anhquan-dao/Power-Meter/reports/cover_page.tex

%!TeX root = power_rail
\documentclass[main.tex]{subfiles}

\begin{document}
    \begin{figure}[!h]
        \hspace{-2.0cm}
        \begin{subfigure}{0.5\textwidth}
         
        \end{subfigure}
        \hspace{6.0cm}
        \begin{subfigure}{0.5\textwidth}
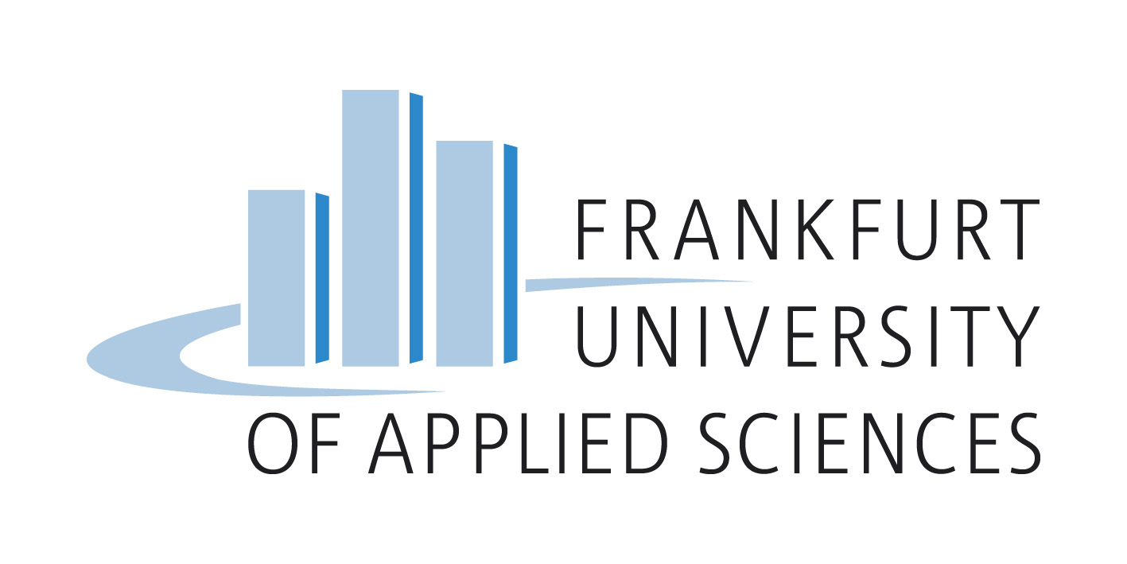
[picture p1: reports/media/FRA-UAS_Logo_rgb.jpg]
        
        \end{subfigure}
    \end{figure}

    \vspace{5mm}
    \center
    \textbf{Vietnamese-German University}
    \center
    \textbf{Department of Electrical Engineering \& Information Technology}
    \vspace{3mm}
    \center
    \textbf{Frankfurt University of Applied Science}
    \center
    \textbf{Faculty 2: Computer Science and Engineering}

    \vspace{2cm}
    \center
    \hspace{-1cm}
    {\Large\textbf{Design and Build a Power Meter with Protection and Visualization}} 
    \hspace{1cm}
    \center
    By
    \center
    {\large\textbf{DAO NGUYEN ANH QUAN}} 
    \center
    \textbf{Matriculation Number: 1318490}
    \center  
    \vspace{5mm}
    {\large\textbf{Supervisor : Dr. THAI TRUYEN DAI CHAN}} 
    \center
    {\large\textbf{Second Supervisor : MSc. NGUYEN VO THAT THUYET}} 

    \vspace{2cm}
    \centerline{Submitted in partial fulfillment of the requirements}
    \centerline{for the degree of Bachelor Engineering in the study program}
    \centerline{Electrical Engineering \& Information Technology,}
    \centerline{Vietnamese-German University.}
    \centerline{Binh Duong, July 2023.}

    \pagebreak
    \section*{\centering{Disclaimer}}
    \justify
    I declare that this report is my analysis of various papers, except the references. All theories, formulas, and models, are researched and collected under the supervisor of MSc. Nguyen Vo That Thuyet, Dr. Thai Truyen Dai Chan.
    \justify
    \hspace{10cm}Dao Nguyen Anh Quan

    \pagebreak
    \section*{\centering{Acknowledgement}}
    \justify
    I would like to extend my most sincere thanks to MSc. Nguyen Vo That Thuyet, Dr. Thai Truyen Dai Chan for his supervision. As well as my peers and my family that has given me advice and support during all this time.

    \pagebreak
    \section*{\centering{Abstract}}
    \justify
    Power monitor is critical in every field of electronics and electrical. Devices used outside their voltage, current and power rating will likely be damaged beyond repair. Thus, in this thesis, the design and construction of an intermediate device between a power supply and a load which provides overvoltage, overcurrent, over-power protection with configurable threshold is discussed. An application is also built to use alongside such device to visualize the opearting voltage and current traces of the load, and to actively disconnect the load.

\end{document}
