anhquan-dao/Power-Meter/reports/MOSFET_selection.tex

%!TeX root = MOSFET_selection
\documentclass[main.tex]{subfiles}

\begin{document}
    \section{MOSFET selection}
    \justify
    In this section, the criteria of selecting a suitable MOSFET are discussed.
    \begin{enumerate}
        \item \nameref{sec:switch_type}.
        \item \nameref{sec:on_resistance}.
        \item \nameref{sec:gate_charge}.
        \item \nameref{sec:soa}.
        \item \nameref{sec:irf4905}.
    \end{enumerate}

    \pagebreak
    \subsection{MOSFET switching principle} \label{sec:switch_type}

    \justify
    The N-channel and P-channel MOSFET have different turn-on conditions:
    \begin{itemize}
        \item For the N-channel MOSFET to be  "switched on" (in triode or saturation region), $V_{gs} > V_{th}$ with Gate-Source threshold voltage $V_{th} > 0$. To achieve this, a simple circuit such as in Figure \ref{fig:simple_nmos_switch} can be used. This configuration is called \textbf{Low-side Switch} where  the switch (MOSFET) is connected to the negative terminal of the supply voltage.
        \item For the P-channel MOSFET, the turn-on condition is $V_{gs} < V_{th}$ with $V_{th} < 0$ which leads to the simple circuit shown in Figure \ref{fig:simple_pmos_switch}. This configuration is called \textbf{High-side Switch} where the switch is connected to the positive terminal of the supply voltage.
    \end{itemize}

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

    \pagebreak
    \subsection{On resistance $R_{ds}$} \label{sec:on_resistance}
    N-channel MOSFET exhibits lower $R_{ds}$ than that of P-channel MOSFET due to packing density. It is possible to parallel two or more P-channel MOSFETs to reduce the total on resistance $R_{\sum ds}$. However, the designer has to take into account devices' parameters mismatch. An application note from Infineon and Texas Instruments \cite{InfineonParallelMOS} details the effects and solutions of each mismatches, suitable for paralleling up to 4 MOSFETs. However, \cite{MOSFET_parallel_low_power} shows that for low power application, the parameter mismatches is not as detrimental as for high power application.
    
    \pagebreak
    \subsection{Gate Charge} \label{sec:gate_charge}

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

    \pagebreak
    \subsection{Safe Operating Area (SOA)} \label{sec:soa}
    In a MOSFET's datasheet, the SOA of the device shows the limitation of the device's opreating range. As long as the desired application is well within the SOA, the device will, in all likelihood, not risk running into problems such as thermal runaway, material degradation, etc. A typical SOA plot of a P-channel MOSFET is shown in figure \ref{fig:typical_SOA_plot}. The SOA lies below the dashed boundary.

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

    \pagebreak
    \subsection{IRF4905S} \label{sec:irf4905}

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

    \end{table}    

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

    \begin{figure}[!h]
        \centerline{}
        \caption{IRF4905 P-channel MOSFET key parameter \cite{IRF4905S}.}
        \label{fig:IRF4905S_param}
    \end{figure}    
    
\end{document}
