anhquan-dao/Power-Meter/reports/application/application.tex

%!TeX root = application
\documentclass[../main.tex]{subfiles}

\begin{document}
    \section{Flask}    \label{sec:flask}
    Flask is a web application framework written in Python. To be more precise, Flask is a microframework which means it is extensible and is not dependent on third-party library, or, in other word, plug and play. The 

    \pagebreak
    \section{Controller's flowchart} \label{sec:application_flowchart}
    The following diagram is the application's flowchart.
    \begin{figure}[!h]
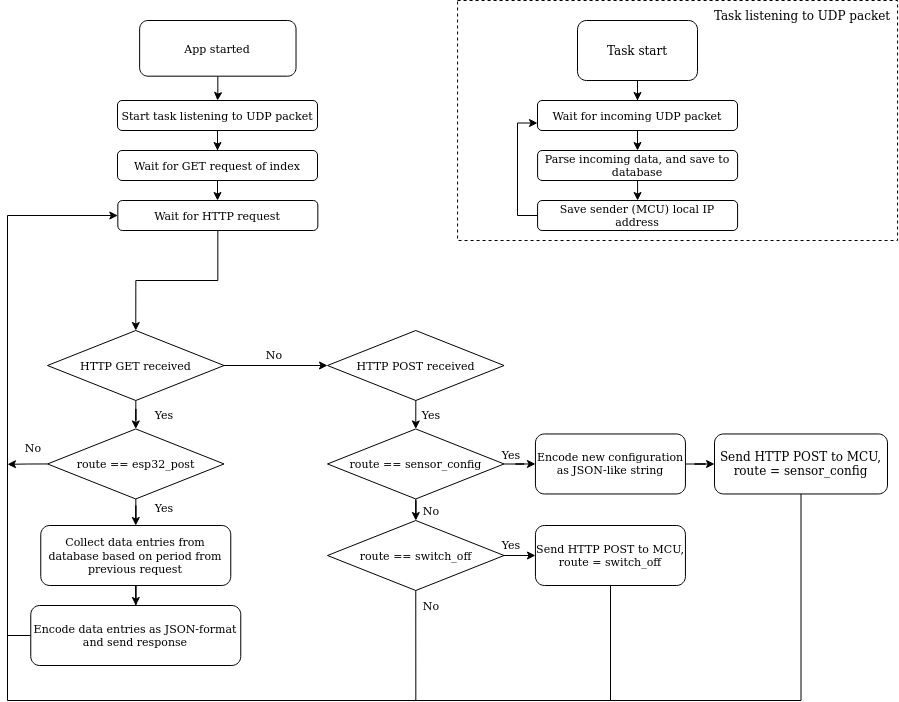
[picture p72: reports/media/appliation_flowchart.drawio.png]
        \centerline{}
        \caption{Application's flowchart.}
        \label{fig:application_flowchart}
    \end{figure}

    \justify
    \begin{itemize} 
        \item An asynchronous task reading incoming UDP packets is started with the application. The asynchronous task parses and saves the incoming data to the database. The sender (MCU)'s local IP address is also stored for other operation.
        \item The web application can then be accessed in the preferred browser with the host PC/laptop's local IP adress at port 8090.
        \item The first GET request is for acquiring the html of the main page.
        \item A GET request with requested resource "esp\_post" is sent every 1000ms from client to the host. The response includes all the data entries from the previous request time up until now. Thus, no data entries sent by the MCU will not be missed.
        \item Other POST requests are "redirected" to the MCU with similar route discussed in previous section.
    \end{itemize}

    \pagebreak
    \section{View's design} \label{sec:application_flowchart}
    \subsection{Embedded JavaScript functions}
    \justify
    The frontend is built using Bootstrap v5.0 framework, Plotly graphing library, and Asynchronous JavaScript and XML (AJAX). The following code snippet shows the JaveScript functions embedded in the .html file.

    \lstinputlisting[language=JavaScript]{code/app/index.js}

    \justify
    \begin{itemize}
        \item The function \lstinline[language=JavaScript]{updateGraph} extends the traces with the values acquired from the server.
        \item The function \lstinline[language=JavaScript]{requestData} is called periodically using \lstinline[language=JavaScript]{setInterval}. After a response is received, the graph is updated with function \lstinline[language=JavaScript]{updateGraph}.
        \item The function \lstinline[language=JavaScript]{submitForm} can be used in \lstinline[language=HTML]{onSubmit} tag of a form element to prevent the page from reloading, and update elements in the background (asynchronously).
    \end{itemize}
    
    \pagebreak
    \subsection{Webpage}
    \justify
    The following figures are the visual design of the webpage of the index.html and config.html respectively. The form in the configuration page uses function \lstinline[language=JavaScript]{submitForm} for its \lstinline[language=HTML]{onSubmit} tag.
    \begin{figure}[!h]
        \centerline{}
        \caption{Index page design}
        \label{fig:index_html}
    \end{figure}
    \begin{figure}[!h]
        \centerline{}
        \caption{Configuration page design}
        \label{fig:config_html}
    \end{figure}

\end{document}
