anhquan-dao/Power-Meter/presentation/media/flask_celery.png

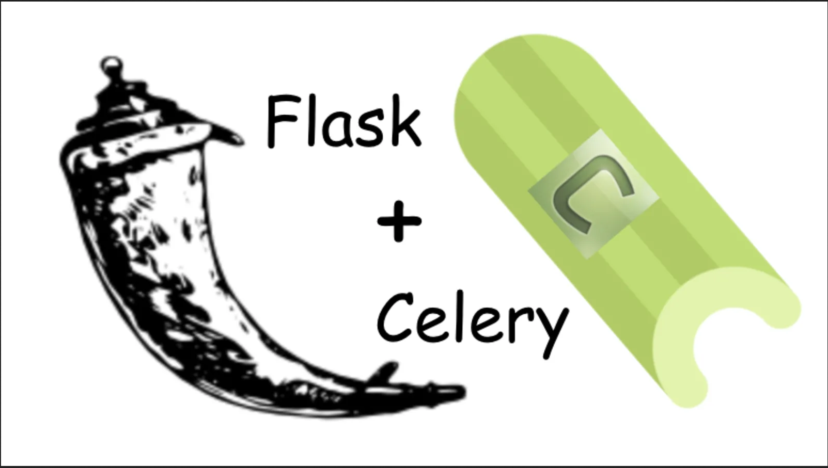
presentation/media/flask_celery.png
