anhquan-dao/Power-Meter/presentation/media/latch_circuit_OFF.png

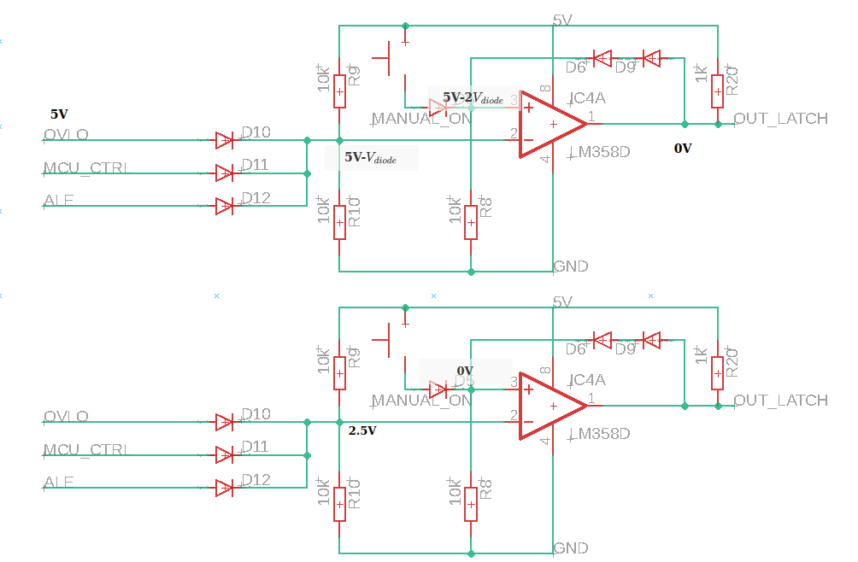
presentation/media/latch_circuit_OFF.png
