anhquan-dao/Power-Meter/reports/media/2.bmp

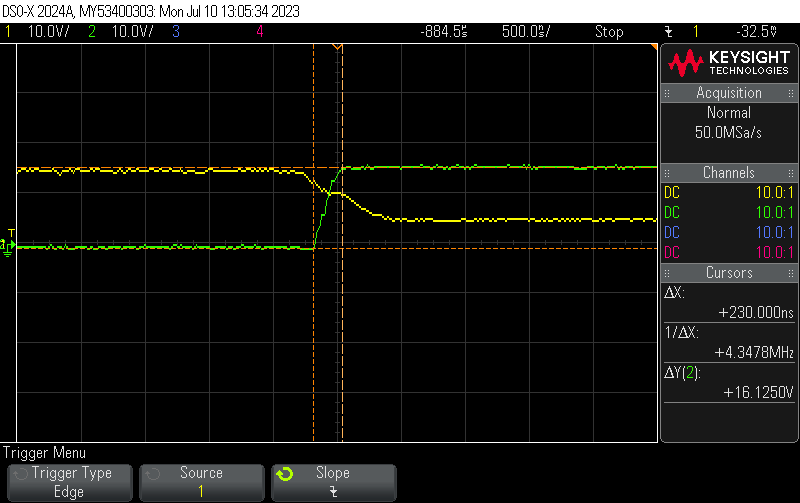
reports/media/2.bmp
