anhquan-dao/Power-Meter/reports/media/example_NMOS_low_switch.png

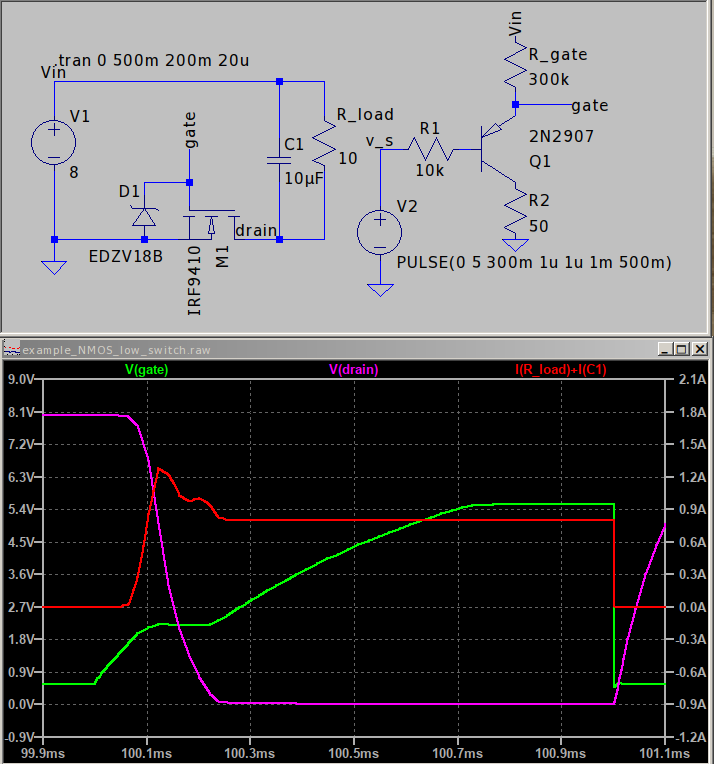
reports/media/example_NMOS_low_switch.png
