anhquan-dao/Power-Meter/reports/media/gate_charge_curve.png

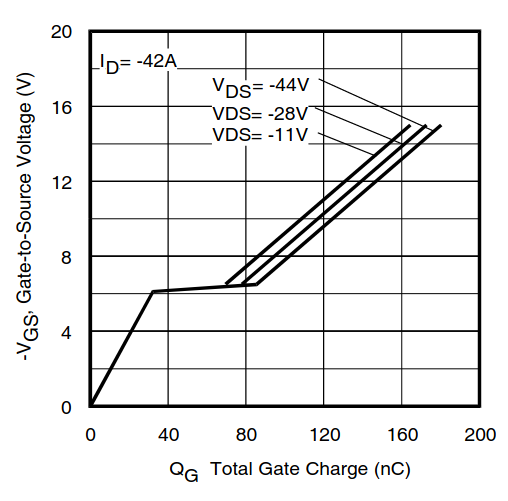
reports/media/gate_charge_curve.png
