anhquan-dao/Power-Meter/reports/media/gate_charge_curve_2.png

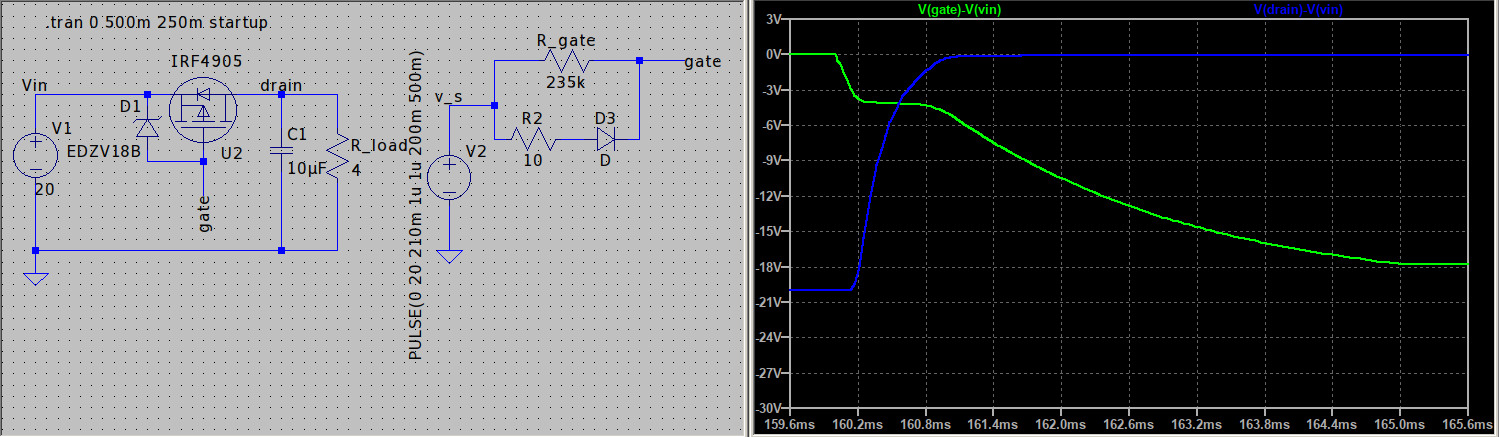
reports/media/gate_charge_curve_2.png
