anhquan-dao/Power-Meter/reports/media/gate_charge_curve_3.png

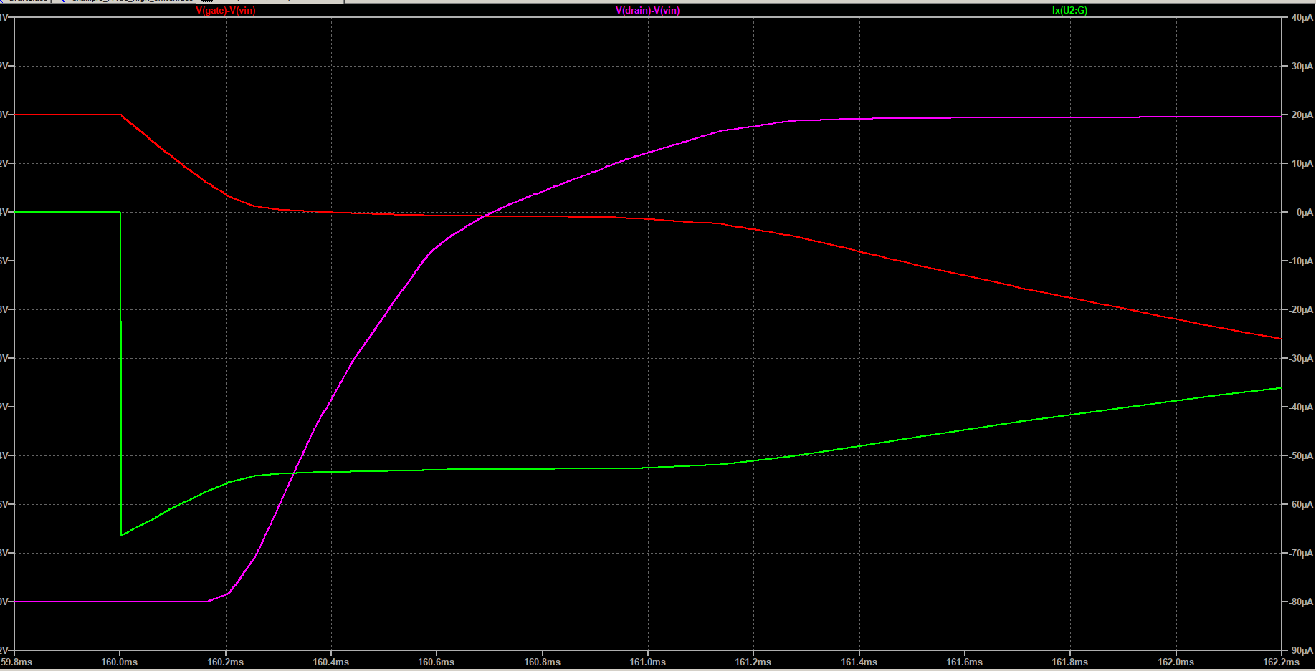
reports/media/gate_charge_curve_3.png
