anhquan-dao/Power-Meter/reports/media/ina226_board.jpeg

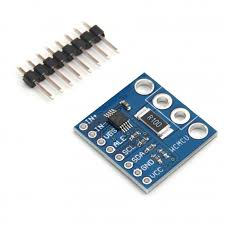
reports/media/ina226_board.jpeg
