anhquan-dao/Power-Meter/reports/media/MC3x063A_inverting_regulator.png

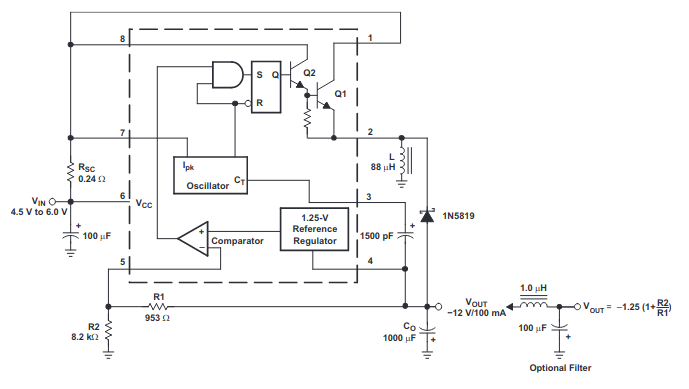
reports/media/MC3x063A_inverting_regulator.png
