anhquan-dao/Power-Meter/reports/media/power-power75.gif

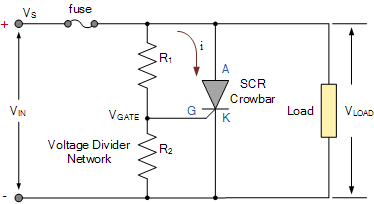
reports/media/power-power75.gif
