anhquan-dao/Power-Meter/reports/media/power_meter_pcb_v2_2_bottom.png

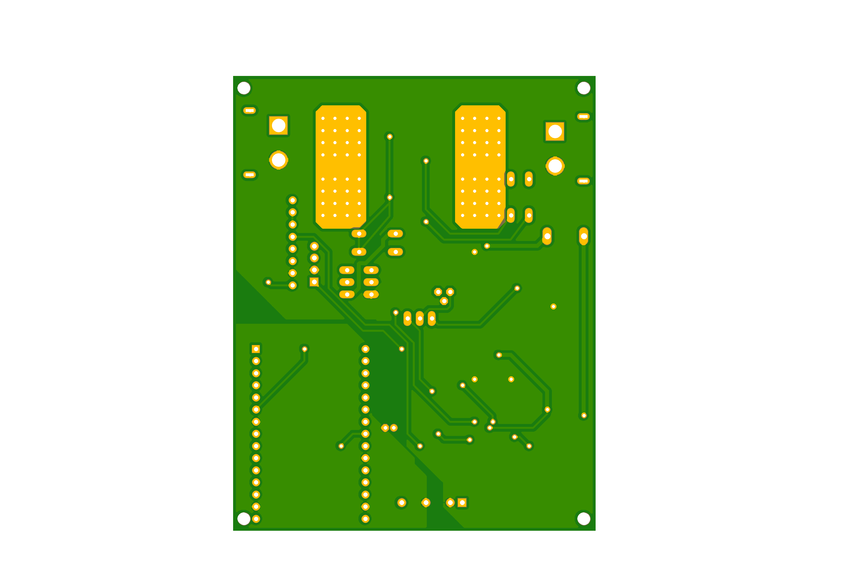
reports/media/power_meter_pcb_v2_2_bottom.png
