anhquan-dao/Power-Meter/reports/media/SOA_circuit.png

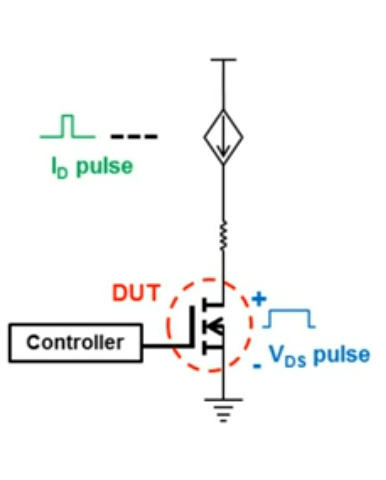
reports/media/SOA_circuit.png
