anhquan-dao/Power-Meter/presentation/build/main.pdf

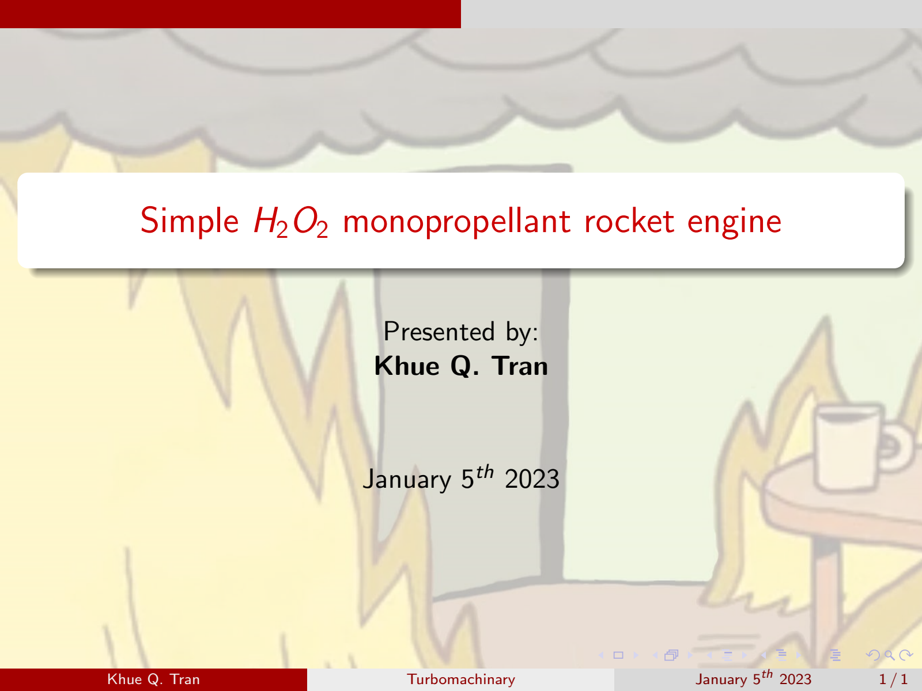
[picture p85: page 1]

## Simple H2O2 monopropellant rocket engine

Presented by:
Khue Q. Tran

January 5th 2023

Khue Q. Tran | Turbomachinary | January 5th 2023 | 1 / 1

Table of conents

Khue Q. Tran | Turbomachinary | January 5th 2023 | 2 / 1

Introduction Safety

## Safety

A rocket engine is always dangerous due to the release of gas and energy! For this rocket engine design, the propellant is high concentration of hydrogen peroxide (H2O2).

At low concentration, H2O2 is safe and used widely for household applications. However, at high concentrations, H2O2 is dangerous due to its oxidizing properties that could lead to skin burn in contact. H2O2 is not stable, may decompose into oxygen and water, and release a lot of energy. This decomposition happens rapidly and lead to damages
H2O2 is not compatible with commons materials: brass (usually used for pneumatics equipments), buna rubber (usually in O-rings/sealing), oil-based grease. The construction materials should be stainless steel or aluminum, Teflon-based O-rings/sealing and grease.
Khue Q. Tran | Turbomachinary | January 5th 2023 | 3 / 1

Introduction System requirements

## Mission type

The concept mission is a small lander: Thrust adequate for the lander: 250N

Required burn time: 40s
Ease to ignite and shut down
Low cost and ease to manufacture


Figure: Masten Xombie test vehicle

Khue Q. Tran | Turbomachinary | January 5th 2023 | 4 / 1

Rocket engine principle de Laval nozzle

## de Laval nozzle


At the convergence section, the flow is ”choked” to sonic flow. Theoretically, any further reduction in cross-section does not increase the flow velocity. Theoretically, the ratio between divergence section inlet and the throat is about 1.5. At the divergence section, the flow is accelerated to supersonic flow. The divergence section expansion ratio depends on the ratio between inlet and ambient pressure. In case of vacuum, the limit factor of
expansion ratio is surface tension
and condensation of the fluid.
Khue Q. Tran | Turbomachinary | January 5th 2023 | 5 / 1

Rocket engine principle de Laval nozzle
The values usually use to parameterize the nozzle’s geometry Throat diameter: from characteristics thrust CF Divergence section
Exit diameter: from expansion ratio At/Ae
Divergence half angle α, usually 15◦

Convergence section
Combustion chamber length: based on combustion, O/F mixing... Combustion chamber diameter: from conctraction ratio Convergence half angle θ, usually in the range of 20◦

to 45◦

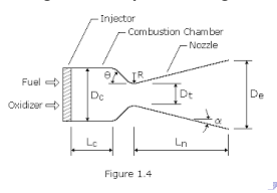
[picture p86: figure]

Khue Q. Tran | Turbomachinary | January 5th 2023 | 6 / 1

Rocket engine principle de Laval nozzle

## Design parameter for a de Laval nozzle

Throat size → Depends on mass flow
rate through the nozzle
Throat expansion ratio, which affects divergence section length is Aexit/Ainlet → Depends on pressure ratio between combustion chamber and ambient, and combustion enthalpy
Convergence and divergence half angles are calculated from real fluid’s surface tension, boundary layer, Raynold number → For an ideal nozzle without any loss, the nozzle could be an orifice. In practice, these angles are usually in a
consistent range

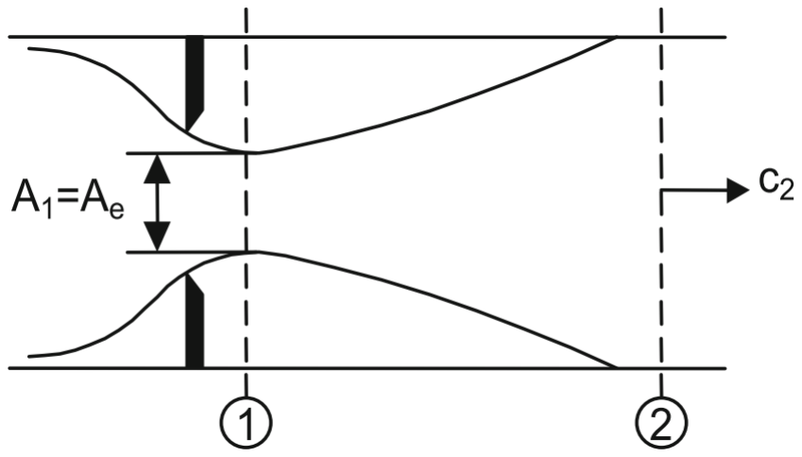
[picture p87: figure]

Khue Q. Tran | Turbomachinary | January 5th 2023 | 7 / 1

## Design parameter for a de Laval nozzle

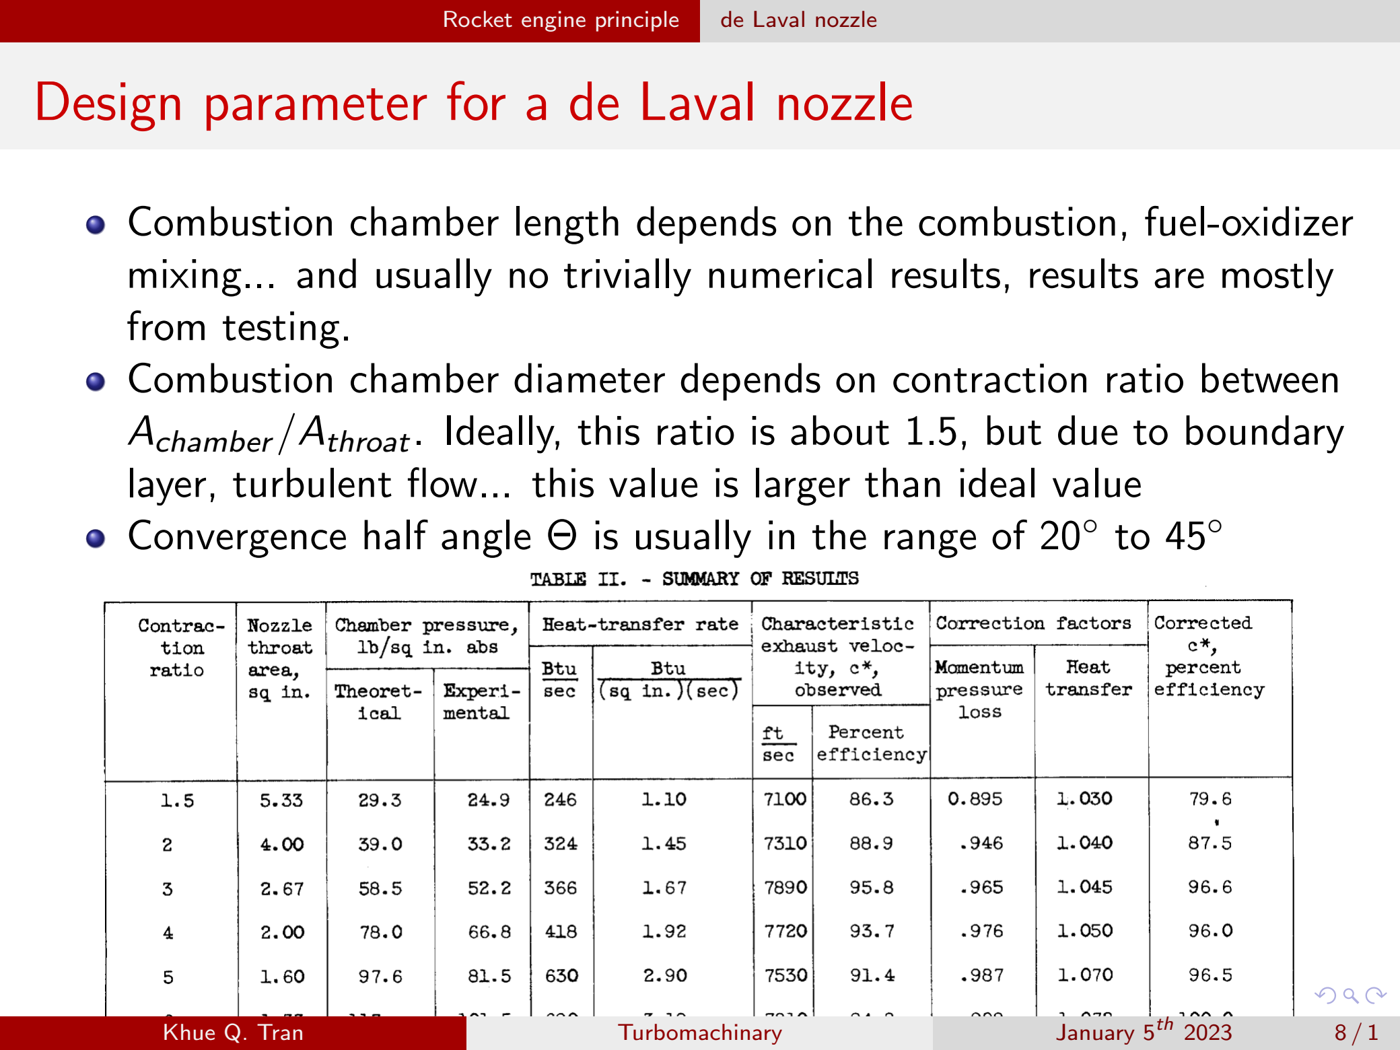
[picture p88: page 8]

Rocket engine principle de Laval nozzle

Combustion chamber length depends on the combustion, fuel-oxidizer mixing... and usually no trivially numerical results, results are mostly from testing.
Combustion chamber diameter depends on contraction ratio between Achamber /Athroat. Ideally, this ratio is about 1.5, but due to boundary layer, turbulent flow... this value is larger than ideal value Convergence half angle Θ is usually in the range of 20◦

to 45◦

Khue Q. Tran | Turbomachinary | January 5th 2023 | 8 / 1

Rocket engine principle Pressure-fed cycle

## Pressure-fed cycle

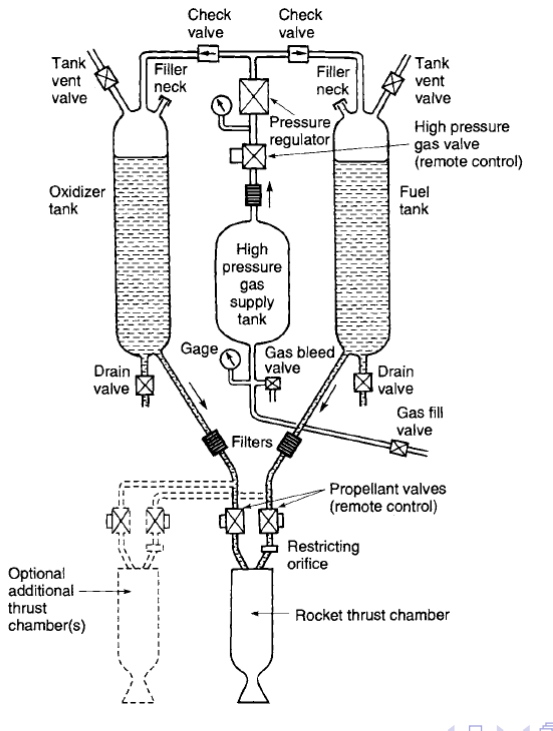
[picture p89: figure]

Khue Q. Tran | Turbomachinary | January 5th 2023 | 9 / 1

Rocket engine principle Hydrogen peroxide

## Why Hydrogen peroxide?

Hydrogen peroxide is a liquid at room temperature and pressure → Could be easily stored and require no thermal insulation

Could decompose and release energy without the presence of other fuels
→ Does not require complex system compared with bipropellant

The decomposition is autogenous with catalyst
→ Ease to ignite and restart
Safe (with low concentration)
→ In case of malfunction, hydrogen peroxide could be easily neutralized by diluting with water
Khue Q. Tran | Turbomachinary | January 5th 2023 | 10 / 1

Rocket engine principle Hydrogen peroxide

## Hydrogen peroxide decomposition

The decomposition of H2O2

2H2O2 → 2H2O + O2

generates ∆H = –2884.5kJ/kg at standard condition T = 25◦C, 1 atm This decomposition usually requires a catalyst. Usually, the catalyst used is silver (both in pure form or silver coated)


Figure: Silver mesh catalyst bed

Khue Q. Tran | Turbomachinary | January 5th 2023 | 11 / 1

Development Engineering consideration

## Engineering consideration

The engine runs on a pressure-fed cycle
High-pressure gas supply tank is limited to 300 bar (30MPa) The engine runs by H2O2 monopropellant (the energy is from the decomposition of H2O2 only)
The concentration of H2O2 is 80%
Khue Q. Tran | Turbomachinary | January 5th 2023 | 12 / 1

Development Sample chamber-nozzle geometry calculation

## First law of thermodynamics

Rocket engine is the heat engine, which must satisfy the first law of Thermodynamics for flow in an adiabatic nozzle

h2 − h1 = −

1
2 × (c

2
2 − c
2/1)

For non-ideal gas, the enthalpy is the function of
H(pressure,Temperature). There are no such models universally, to determine these enthalpy values
→ The enthalpy values usually come from real measurement, and complex state equations, for each kind of substance! Usually, we use numerical software to calculate the thermodynamic properties of the rocket engine.
Khue Q. Tran | Turbomachinary | January 5th 2023 | 13 / 1

Development Sample chamber-nozzle geometry calculation

## NASA CEA demo for thermodynamics calculation

Initial conditions
H2O2 80% monopropellant (20% left is water)

Combustion chamber pressure is 30 bar, ambient pressure is 1 bar, ratio=30
Initial H2O2 temperature: 293.15K

https://cearun.grc.nasa.gov/

Khue Q. Tran | Turbomachinary | January 5th 2023 | 14 / 1

Development Sample chamber-nozzle geometry calculation

## Sample NASA CEA result

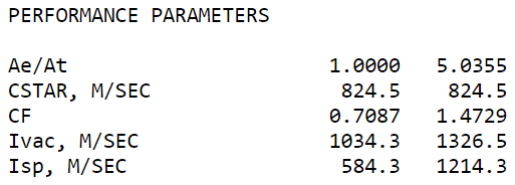
[picture p90: figure]

Khue Q. Tran | Turbomachinary | January 5th 2023 | 15 / 1

Development Sample chamber-nozzle geometry calculation

## Sample chamber-nozzle geometry calculation

The combustion temperature is 782.05K (508.9

◦C. It is a relatively
low value for metal materials. Hence, it does not require to cool down the engine, and no need to calculate heat transfer

For the required thrust of 250N, the required mass flow rate is

m˙ [kg] = Fthrust[N]
Isp[m/s] =

250N
1214.3m/s = 0.206kg/s

Throat area
At

[in²

] = Fthrust[lbf ] Cf ×pchamber [psi] =
56.2lbf
1.4729×435.1psi = 0.0877in² = 56.59mm²

→ The throat diameter Dthroat = 8.5mm

Nozzle exit diameter

Dexit = Dthroat ×

q Aexit

Athroat

= 8.5mm ×

√
5.0355 = 19.1mm
Khue Q. Tran | Turbomachinary | January 5th 2023 | 16 / 1

Development Sample chamber-nozzle geometry calculation

## Sample chamber-nozzle geometry calculation

For this simple engine, some characteristics properties are Geometry is linear (which is about 93% efficiency)

Combustion chamber-throat concentration: 2.5

dchamber = dthroat ×

√
contraction ratio = 8.5mm ×

√
2.5 = 13.44mm
Combustion chamber length/diameter ratio: 4

Lchamber = dchamber ×

L
D = 13.44mm × 4 = 53.76mm
Converging half angle: Θ = 30◦ Diverging half angle: α = 15◦
Khue Q. Tran | Turbomachinary | January 5th 2023 | 17 / 1

Development Sample chamber-nozzle geometry calculation

## Sample chamber-nozzle geometry calculation

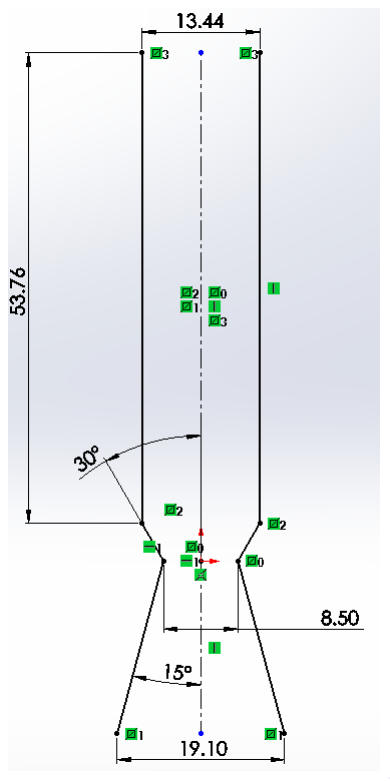
[picture p91: figure]

Khue Q. Tran | Turbomachinary | January 5th 2023 | 18 / 1

Development Sample chamber-nozzle thickness calculation

## Sample chamber-nozzle thickness calculation

Due to manufacturing constraints, the nozzle assembly is 3D-printed, AlSi10Mg alloy. This material has tensile strength of 210MPa. Safety factor for this engine is at least SF = 2 . There are 3 consumptions The material loss 30% percent of its strength at 782.05K

The thickness is the same for the whole assembly. The 3D-printed part strength is homogeneous in all directions
The stress is highest at combustion chamber
Hoop (Circumferential) Stress for thin-walled vessel

σh × SF =

pd
2t
Longitudinal (Axial) Stress for thin-walled vessel

σl × SF =

pd
4t
⇒ t = 2.5mm with SF = 2.3
Khue Q. Tran | Turbomachinary | January 5th 2023 | 19 / 1

Development | Sample chamber-nozzle thickness calculation

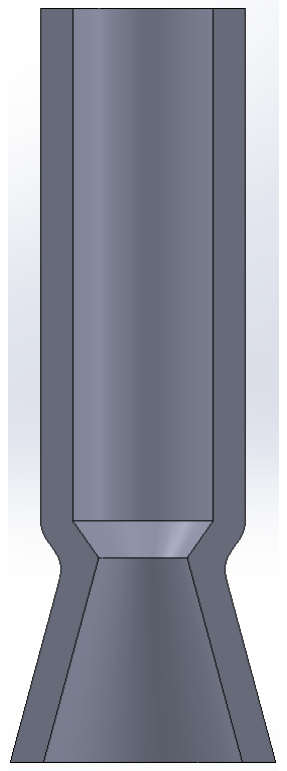
[picture p92: figure]

Khue Q. Tran | Turbomachinary | January 5th 2023 | 20 / 1

Development Simple injector

## Simple injector

A rocket engine injectors has two main contributions
Mix the fuel and oxidizer
Act as a flow-restricting orifice to prevent the combustion gas to blow-back into feed line. This is different from normal injector that used in internal-combustion engine as rocket engine is a continuously flow engine

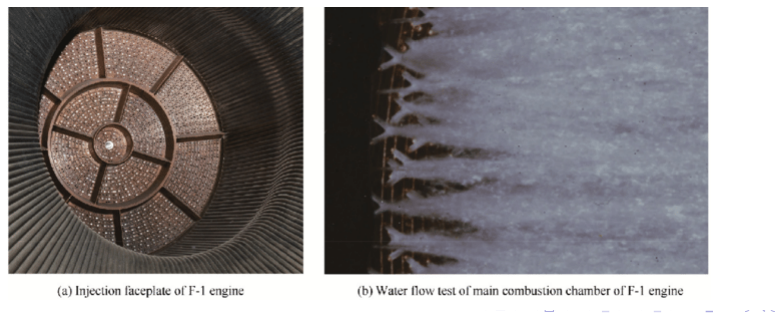
[picture p93: figure]

Khue Q. Tran | Turbomachinary | January 5th 2023 | 21 / 1

Development Simple injector

For our simple H2O2 engine, there is no mixing as our engine is monopropellant.
→ The nozzle could be a simple spray nozzle.

For combustion stability, the pressure drop through the injector is 15% to 20%
→ For combustion pressure of 30 bar, the pressure drop is 6 bar. Also, as the mass flow rate is ˙m = 0.206kg/s and ρH2O2 = 1.4kg/l, the volumetric flow rate is V˙ = 0.2884l/s = 4.57gpm (gallon per minute)

From volumetric flow rate and pressure drop,
we could find the spray nozzle orifice diameter (ISO 5167 standard for spray nozzle). An online tool: http://www.pressure-drop.com/Online-Calculator/index.html (http://www.pressure-drop.com/Online-Calculator/index.html)

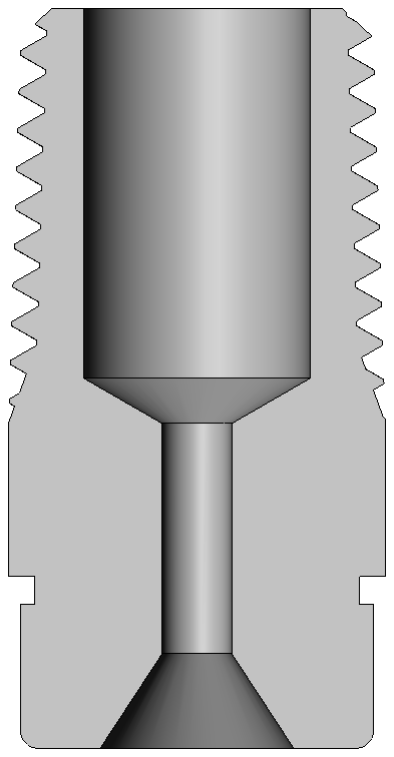
[picture p94: figure]

Khue Q. Tran | Turbomachinary | January 5th 2023 | 22 / 1

Development Simple injector

## McMaster-Carr nozzle

Instead of calculating, the flowrate and pressure drop could be supplied by the spray nozzle manufacture. In this case, we chose Mcmaster-Carr 32885K571 spray nozzle (https://www.mcmaster.com/32885K571/)

This spray nozzle is stainless steel
This spray nozzle is 120◦
, full-cone type

Flow rate at 100psi pressure drop is 4.6gpm

Khue Q. Tran | Turbomachinary | January 5th 2023 | 23 / 1

Design result

## Overall CAD file

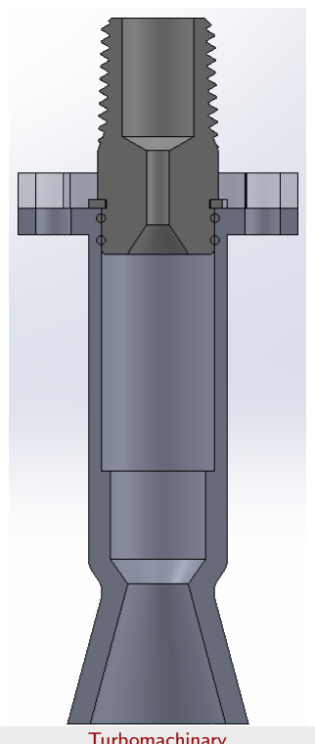
[picture p95: figure]

Khue Q. Tran | Turbomachinary | January 5th 2023 | 24 / 1

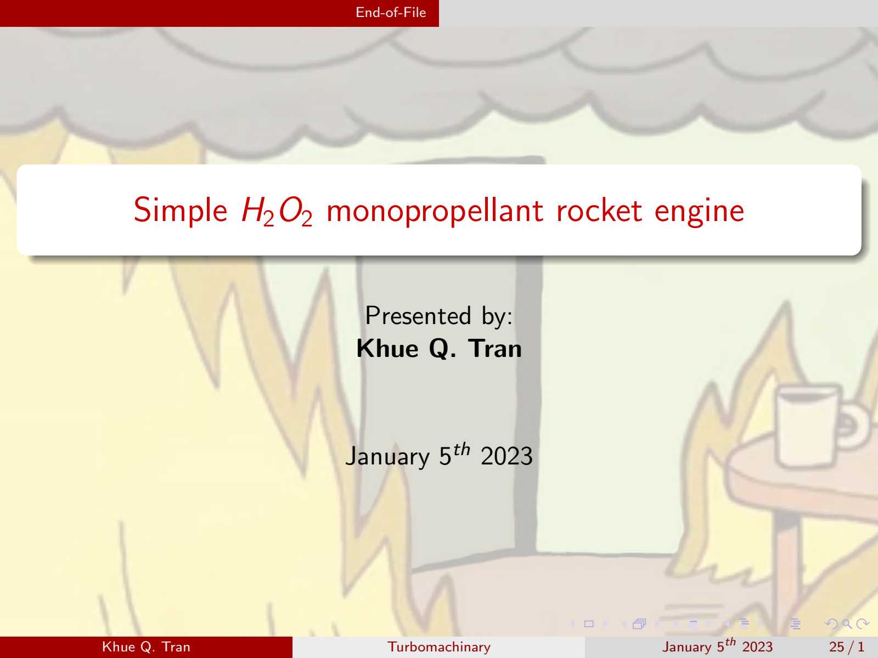
[picture p96: page 25]

End-of-File

## Simple H2O2 monopropellant rocket engine

Presented by:
Khue Q. Tran

January 5th 2023

Khue Q. Tran | Turbomachinary | January 5th 2023 | 25 / 1
