anhquan-dao/Power-Meter/ltspice/example_PMOS_high_switch_test_logic.asc

1_2ref: voltage; 1.2
5V: voltage; 5V
C1: cap; 100µF
C2: cap; 0.1µF
C3: cap; 1µF
C4: cap; 1µ
D1: zener; EDZV18B
D2: zener; EDZV18B
D3: schottky
D4: zener; BZX84C13VLY
D5: diode
D6: diode
D7: diode
D8: diode
Q1: npn; 2N2222
Q2: npn; 2N2222
R1: res; 50
R2: res; 3k3
R3: res; 10k
R4: res; 2k5
R5: res; 10k
R6: res; 50
R7: res; 27k
R8: res; 1k
R9: res; 10k
R10: res; 3k
R11: res; 100k
R12: res; 1k
R13: res; 2k2
R14: res; 3k3
R15: res; 3k
R19: res; 10k
R20: res; 1k
R21: res; 2k2
R_gate2: res; 1k
R_load: res; 9
S1: sw; SW_1
U1: irf4905
U2: irf4905
U3: lm393
U4: lm393
U6: 74hc373
U7: 74hc32
U8: lm393
U9: irf4905
U10: irf4905
U11: lm393
V1: voltage; PULSE(5 18 0 1u 1u 200m 500m 2)
V2: voltage; PULSE(0 5 500m 1u 1u 10m 0 1)
V3: jumper2
Named nets: 0, out, gate, Vin, Vpos, 1_2ref, UVLO, OVLO, 5V, reverse_gate, gate_control, latch_ctrl
.tran 0 800m 0 startup
.param V_in=30
.param R_L = (V_in^2)/100
.Model SW_1 SW(Ron=10m Roff=100Meg Vt=3)
