anhquan-dao/Power-Meter/ltspice/PMOS_sw_reduced_parts.asc

1_2ref: voltage; 1.2
ALE: voltage; PULSE(0 5 100m 1u 1u 5m)
C1: cap; 100µF
C3: cap; 1µF
D1: zener; EDZV18B
D2: zener; EDZV18B
D3: schottky
D4: diode; 1N4148
D6: schottky; 1N5817
D7: schottky; 1N5817
D9: diode; 1N4148
D10: diode; 1N4148
D11: diode; 1N4148
Q1: npn; 2N2222
Q2: npn; 2N2222
Q3: npn
R1: res; 50
R2: res; 3k3
R3: res; 1k
R4: res; 3k3
R5: res; 1k1
R6: res; 10k
R7: res; 27k
R8: res; 1k
R9: res; 10k
R10: res; 1k
R11: res; 100k
R12: res; 10k
R13: res; 10k
R14: res; 1k
R15: res; 1k
R16: res; 6k8
R19: res; 10k
R20: res; 10k
R21: res; 10k
R_gate2: res; 1k
R_load: res; 9
RESET: voltage; PULSE(0 5 0 1u 1u 10m 160m 2)
U1: irf4905
U2: irf4905
U3: TL431
U4: lm393
U5: 7805
U6: lm393
U7: irf4905
U9: irf4905
U10: irf4905
U11: lm393
V1: voltage; PULSE(5 24 0 1u 1u 200m 500m 2)
Named nets: 0, out, gate, Vin, Vpos, 1_2ref, OVLO, 5V, reverse_gate, gate_ctrl, OCP
.tran 0 800m 0 1m startup
.param V_in=30
.param R_L = (V_in^2)/100
.Model SW_1 SW(Ron=10m Roff=100Meg Vt=3)
