anhquan-dao/Power-Meter/ltspice/example_PMOS_high_switch.asc

5V: voltage; PULSE(5 0 200m 1u 1u 100m)
C1: cap; 100µF
D1: zener; EDZV18B
Q1: npn; 2N2222
R_1: res; 4k7
R_gate: res; 500
R_load: res; 4.7
R_pullup: res; 10k
U2: irf4905
V1: voltage; PULSE(0 24 0 1u 1u 500m)
Named nets: 0, out, gate, Vin
.tran 0 500m 0 startup
