anhquan-dao/Power-Meter/ltspice/Draft1.asc

C_ds: cap; ""
C_gd: cap; ""
C_gs: cap; ""
I1: current; ""
M1: pmos
Named nets: 0, Vin, signal
