anhquan-dao/Power-Meter/ltspice/Draft2.asc

C1: polcap; 3.375n
R1: res; 300k
V1: voltage; 8V
Named nets: 0
.tran 100m startup
