anhquan-dao/Power-Meter/ltspice/example2_NMOS_low_switch.asc

M1: nmos; IRF9410
R_gate: res; 50
R_load: res; 10; tol=0.0001 pwr=100w
U1: 7805
V1: voltage; PULSE(10 4)
V2: voltage; PULSE(0 4 300m 1u 1u 200m 500m)
Named nets: 0, drain, v_s, gate
.tran 0 500m 200m 20u
