anhquan-dao/Power-Meter/ltspice/FastMos4.asc

C1: cap; 220pF
D1: schottky; BAT46WJ
D2: schottky; BAT46WJ
M1: pmos; Si7489DP
Q1: npn; 2N3904
Q2: npn; 2N3904
Q3: npn; 2N3904
Q4: pnp; 2N3906
Q5: pnp; 2N4403
Q6: npn; 2N4401
R1: res; 1K
R2: res; 2K4
R3: res; 47
R4: res; 100
R5: res; 47
R6: res; 100
Rload2: EuropeanResistor; 10
V1: voltage; PULSE(5 0 25u 10n 10n 200u 400u)
Vcc: voltage; {VCC}
Named nets: 0, Vcc, pulse, g, d, b
Wide Vcc range fast PMOS gate driver
.tran 1m
Set
Max Vgs
.step param VCC list 8 12 16 32
matched pair
.param VCC 24
Use 620R
for 3.3V
logic
