anhquan-dao/Power-Meter/ltspice/PMOS_sw_crowbar.asc

Q1: pnp
R1: res; 1k
R2: res; 1k
R17: res; 220
R18: res; 12k
R22: res; 1k
U1: ScrA
U6: fuse2
U12: TL431
V1: voltage; PULSE(15 35 100m 1u 1u 200m 500m 2)
Named nets: 0, Vpos
.tran 0 200m 0 1m startup
