anhquan-dao/Power-Meter/(commit log)

2023-04-14 Inital commit
    [custom_part.csv]
2023-04-23 Successfully read data from sensor and connect to the app.
